nathaniel-feldman/week-esp32-airboat/images/IMG_0020.jpeg

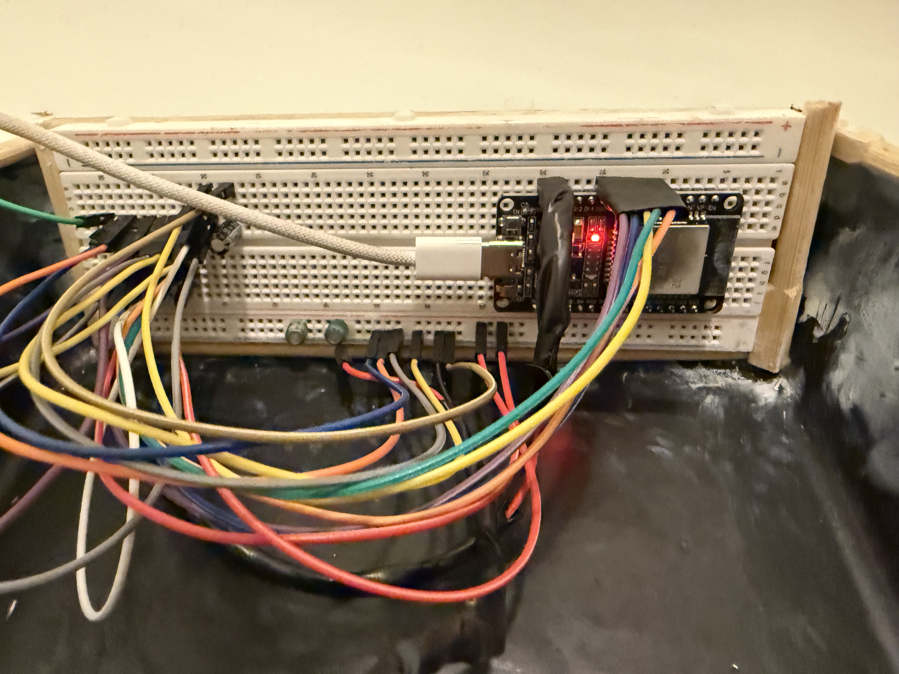
images/IMG_0020.jpeg
