nathaniel-feldman/week-esp32-airboat/images/IMG_0021.jpeg

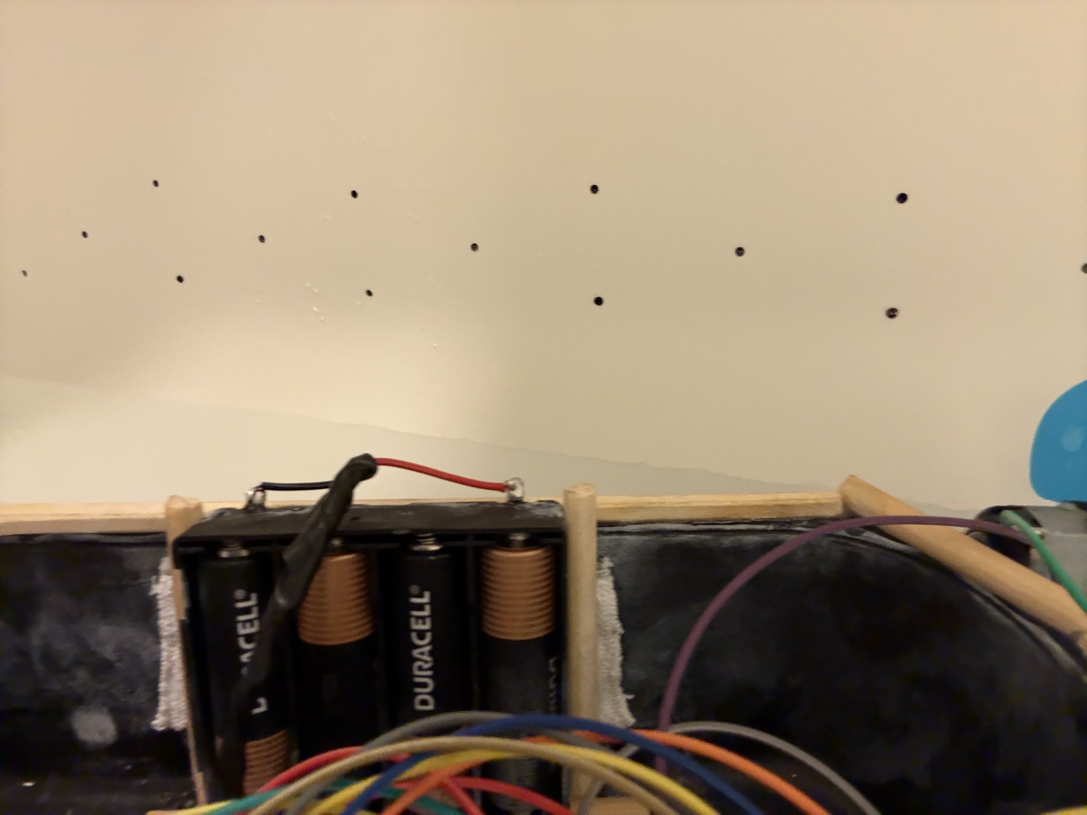
images/IMG_0021.jpeg
