nathaniel-feldman/week-esp32-airboat/(commit log)

2026-07-13 Add ArduinoIDE code
2026-07-13 Add wiring schematic
