nathaniel-feldman/week-esp32-airboat/images/IMG_4881.jpeg

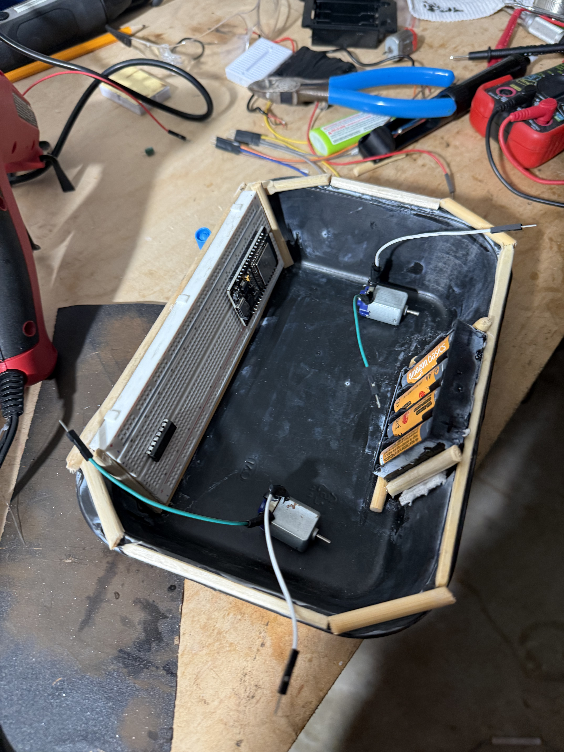
images/IMG_4881.jpeg
