nathaniel-feldman/week-esp32-airboat/images/IMG_4877.jpeg

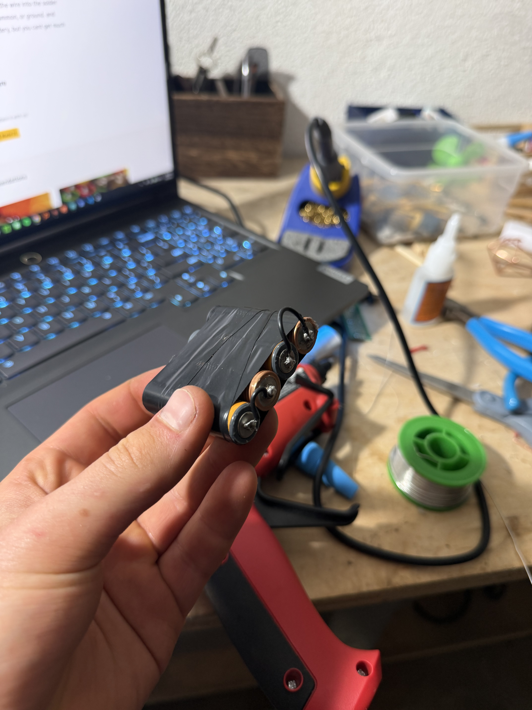
images/IMG_4877.jpeg
