nathaniel-feldman/week-esp32-airboat/images/IMG_0019.jpeg

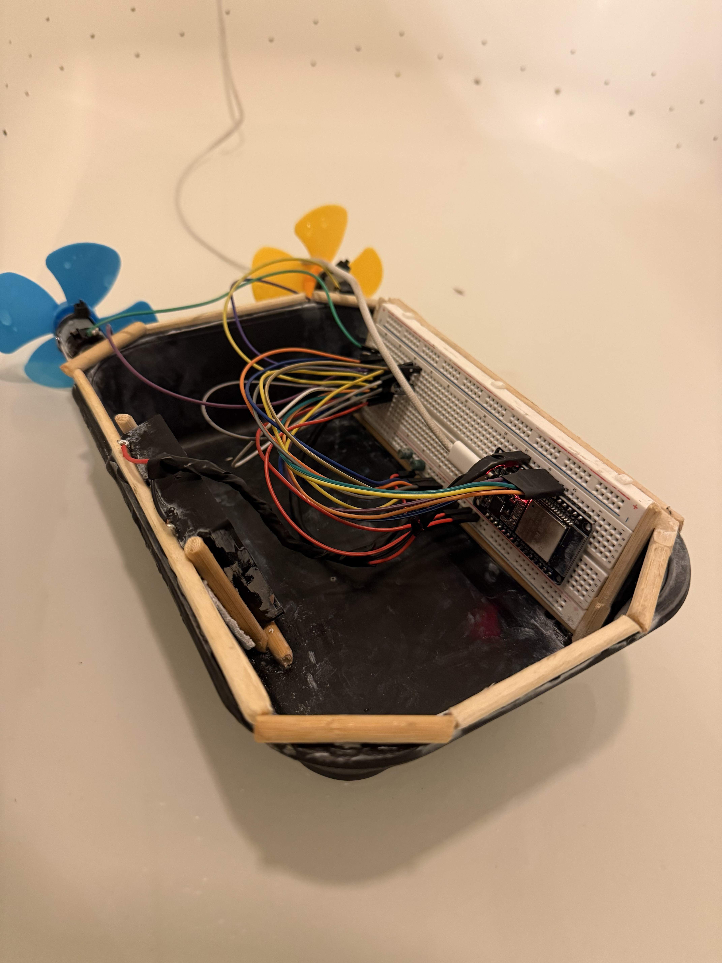
images/IMG_0019.jpeg
